zephray/BenqS6-SSD/README.md

# BenqS6-SSD

Replacement SSD for Benq S6

Controller: SM2258XT
Flash: BGA 152pin Flash, up to 2 channel 8 CE
Interface: PATA UDMA up to 150 MB/s (if host supports)
