zephray/BenqS6-SSD/pcb/pcb.kicad_pcb

## KiCad design pcb/pcb.kicad_pcb (2021-12-24)

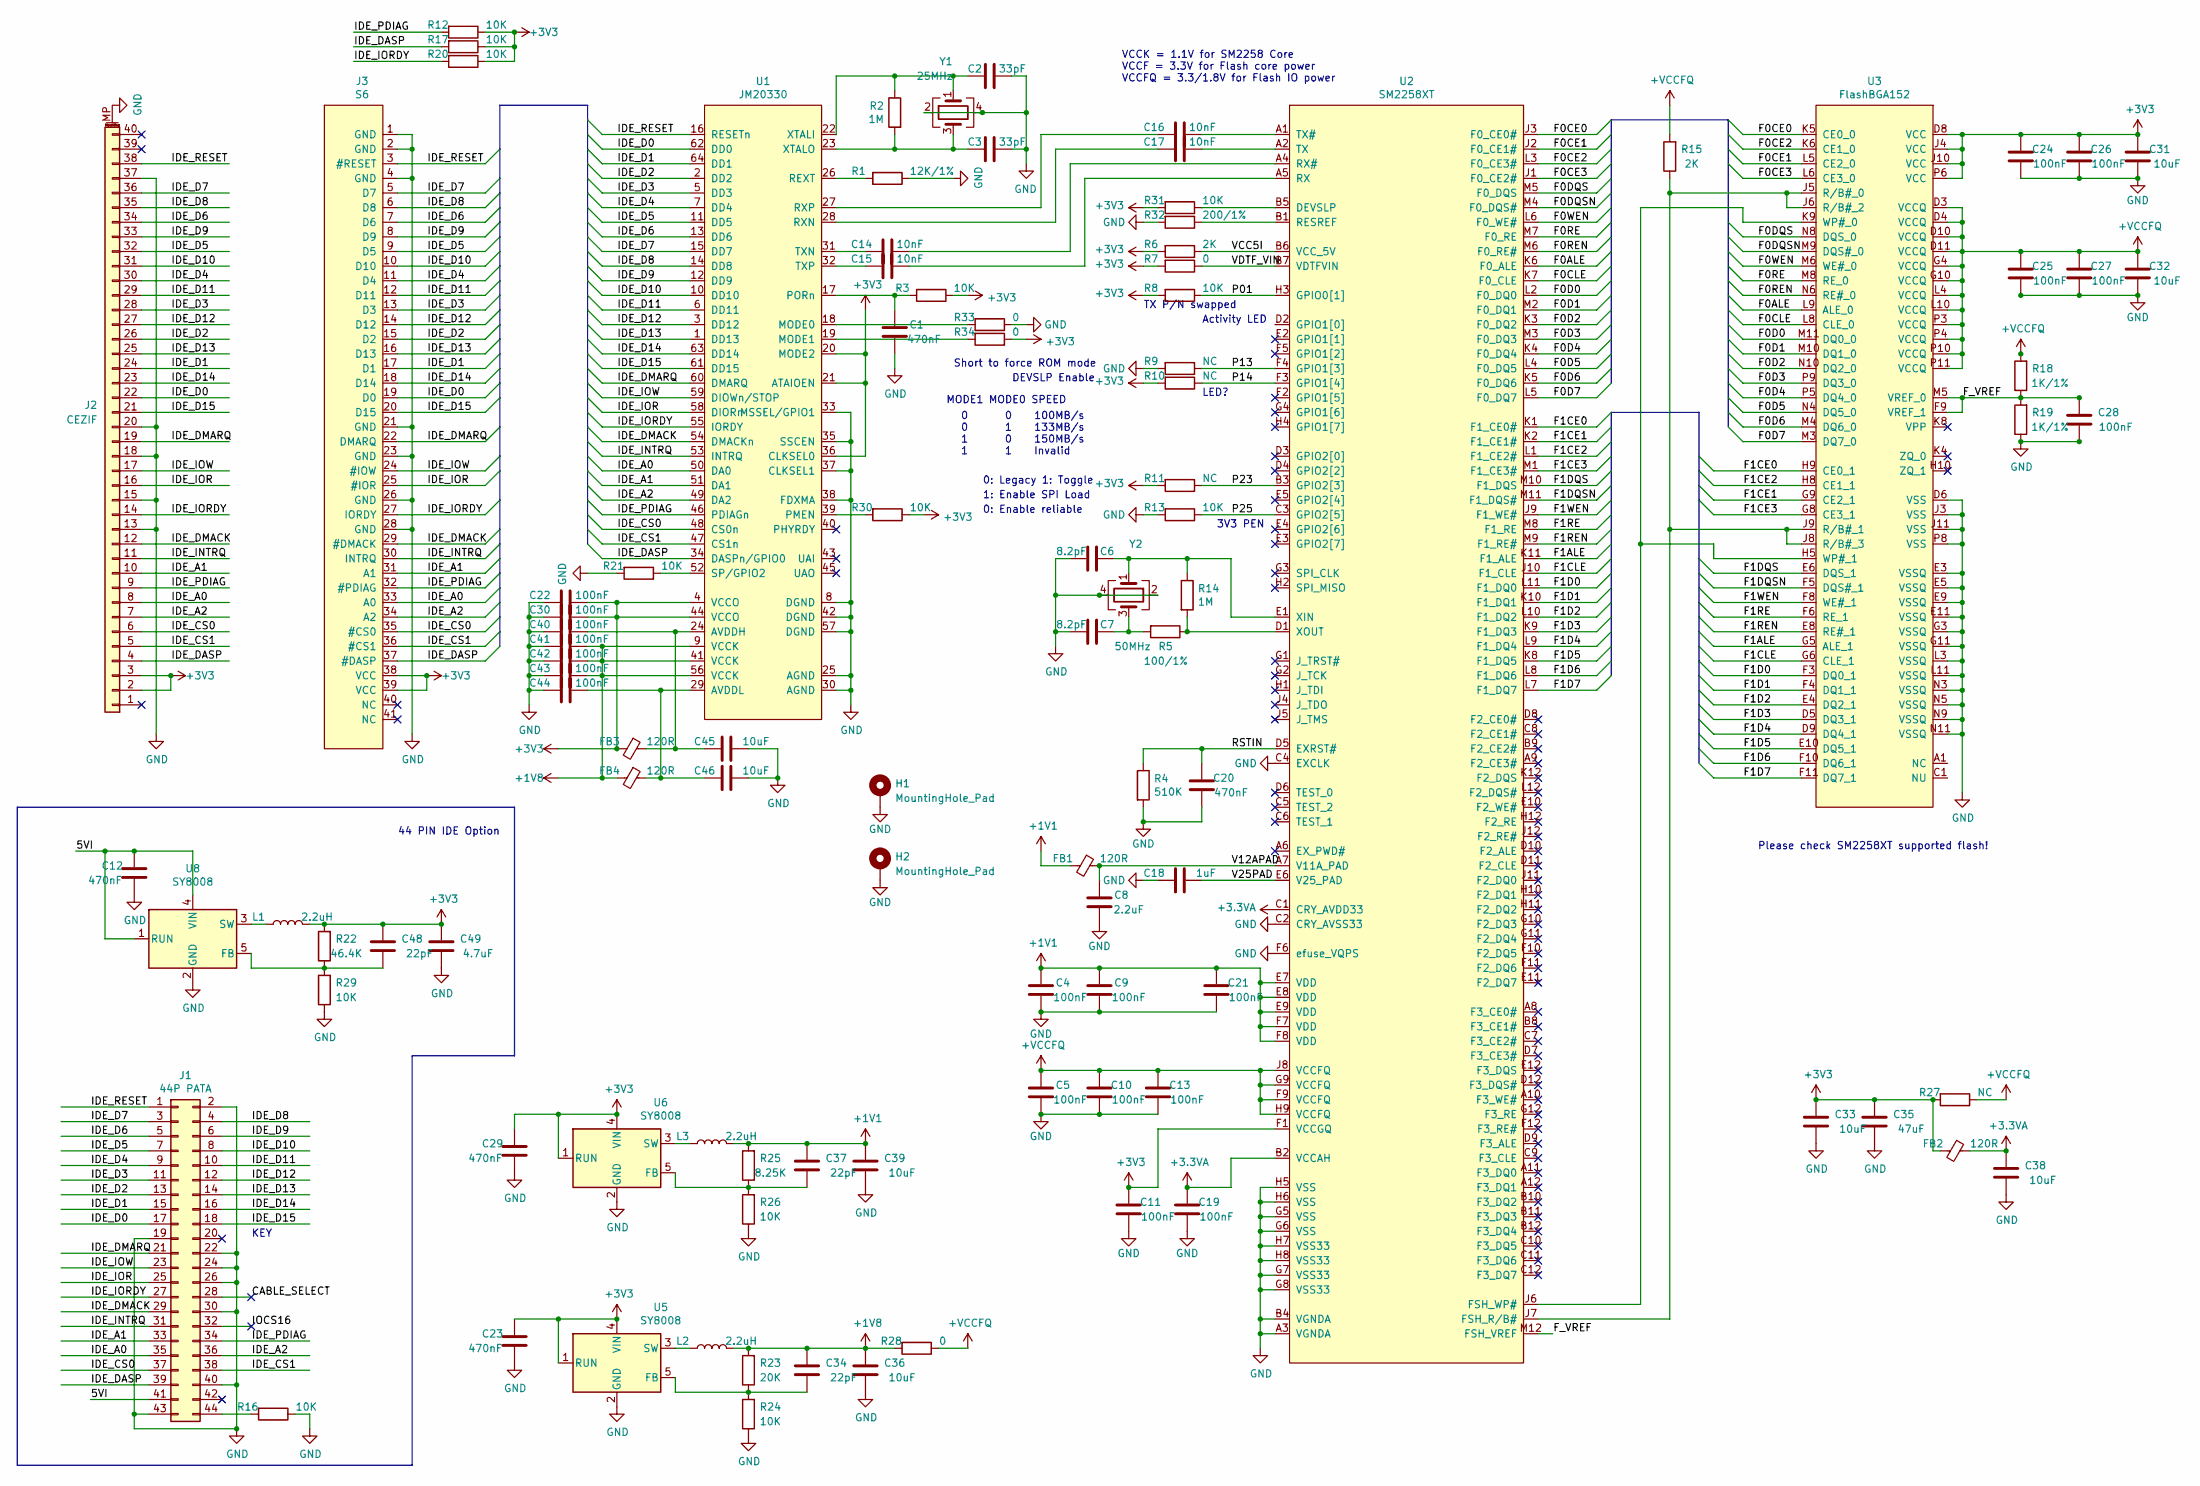
[picture p1: schematic pcb.kicad_sch]

Parts:
C1, C12, C20, C23, C29: 470nF; C_0402_1005Metric
C2, C3: 33pF; C_0402_1005Metric
C4, C5, C9, C10, C11, C13, C19, C21, C22, C24, C25, C26, C27, C28, C30, C40, C41, C42, C43, C44: 100nF; C_0402_1005Metric
C6, C7: 8.2pF; C_0402_1005Metric
C8: 2.2uF; C_0402_1005Metric
C14, C15, C16, C17: 10nF; C_0402_1005Metric
C18: 1uF; C_0402_1005Metric
C31, C32, C33, C36, C38, C39, C45, C46: 10uF; C_0402_1005Metric
C34, C37, C48: 22pF; C_0402_1005Metric
C35: 47uF; C_0805_2012Metric
C49: 4.7uF; C_0402_1005Metric
FB1, FB2, FB3, FB4: 120R; L_0603_1608Metric
H1, H2: MountingHole_Pad; MountingHole_2.2mm_M2_Pad_Via
J1: 44P PATA; PinHeader_2x22_P2.00mm_Vertical
J2: CEZIF; Hirose_FH12-40S-0.5SH_1x40-1MP_P0.50mm_Horizontal
J3: S6; FH35C-41S-0.3SHW
L1, L2, L3: 2.2uH; L_Vishay_IHLP-1212
R1: 12K/1%; R_0402_1005Metric
R2, R14: 1M; R_0402_1005Metric
R3, R8, R12, R13, R16, R17, R20, R21, R24, R26, R29, R30, R31: 10K; R_0402_1005Metric
R4: 510K; R_0402_1005Metric
R5: 100/1%; R_0402_1005Metric
R6, R15: 2K; R_0402_1005Metric
R7, R28, R33, R34: 0; R_0402_1005Metric
R9, R10, R11, R27: NC; R_0402_1005Metric
R18, R19: 1K/1%; R_0402_1005Metric
R22: 46.4K; R_0402_1005Metric
R23: 20K; R_0402_1005Metric
R25: 8.25K; R_0402_1005Metric
R32: 200/1%; R_0402_1005Metric
U1: JM20330; LQFP-64_10x10mm_P0.5mm
U2: SM2258XT; BGA-144_12x12_9.0x9.0mm
U3: FlashBGA152; BGA-152_14x18mm_Layout13x17_P0.5mm
U5, U6, U8: SY8008; TSOT-23-5
Y1: 25MHz; Oscillator_SMD_Abracon_ASE-4Pin_3.2x2.5mm
Y2: 50MHz; Oscillator_SMD_Abracon_ASE-4Pin_3.2x2.5mm

Connections:
+1V1: C4.2, C9.2, C21.2, C37.2, C39.2, FB1.2, L3.2, R25.2, U2.E7 (VDD), U2.E8 (VDD), U2.E9 (VDD), U2.F7 (VDD), U2.F8 (VDD)
+1V8: C34.2, C36.2, C41.2, C42.2, C43.2, FB4.2, L2.2, R23.2, R28.2, U1.9 (VCCK), U1.41 (VCCK), U1.56 (VCCK)
+3.3VA: C19.2, C38.2, FB2.1, U2.B2 (VCCAH), U2.C1 (CRY_AVDD33)
+3V3: C11.2, C22.2, C23.2, C24.2, C26.2, C29.2, C30.2, C31.2, C33.2, C35.2, C48.2, C49.2, FB2.2, FB3.2, J2.2, J2.3, J3.38 (VCC), J3.39 (VCC), L1.2, R3.1, R6.2, R7.2, R8.2, R10.2, R11.2, R12.1, R17.1, R20.1, R22.2, R27.2, R30.1, R31.2, R34.1, U1.4 (VCCO), U1.20 (MODE2), U1.21 (ATAIOEN), U1.36 (CLKSEL0), U1.44 (VCCO), U2.F1 (VCCGQ), U3.D8 (VCC), U3.J4 (VCC), U3.J10 (VCC), U3.P6 (VCC), U5.1 (RUN), U5.4 (VIN), U6.1 (RUN), U6.4 (VIN)
+VCCFQ: C5.2, C10.2, C13.2, C25.2, C27.2, C32.2, R15.2, R18.2, R27.1, R28.1, U2.F9 (VCCFQ), U2.G9 (VCCFQ), U2.H9 (VCCFQ), U2.J8 (VCCFQ), U3.C2 (NU), U3.D3 (VCCQ), U3.D4 (VCCQ), U3.D10 (VCCQ), U3.D11 (VCCQ), U3.G4 (VCCQ), U3.G10 (VCCQ), U3.L4 (VCCQ), U3.L10 (VCCQ), U3.P3 (VCCQ), U3.P4 (VCCQ), U3.P10 (VCCQ), U3.P11 (VCCQ)
/F0ALE: U2.K6 (F0_ALE), U3.L9 (ALE_0)
/F0CE0: U2.J3 (F0_CE0#), U3.K5 (CE0_0)
/F0CE1: U2.J2 (F0_CE1#), U3.L5 (CE2_0)
/F0CE2: U2.L3 (F0_CE3#), U3.K6 (CE1_0)
/F0CE3: U2.J1 (F0_CE2#), U3.L6 (CE3_0)
/F0CLE: U2.K7 (F0_CLE), U3.L8 (CLE_0)
/F0D0: U2.L2 (F0_DQ0), U3.M11 (DQ0_0)
/F0D1: U2.M2 (F0_DQ1), U3.M10 (DQ1_0)
/F0D2: U2.K3 (F0_DQ2), U3.N10 (DQ2_0)
/F0D3: U2.M3 (F0_DQ3), U3.P9 (DQ3_0)
/F0D4: U2.K4 (F0_DQ4), U3.P5 (DQ4_0)
/F0D5: U2.L4 (F0_DQ5), U3.N4 (DQ5_0)
/F0D6: U2.K5 (F0_DQ6), U3.M4 (DQ6_0)
/F0D7: U2.L5 (F0_DQ7), U3.M3 (DQ7_0)
/F0DQS: U2.M5 (F0_DQS), U3.N8 (DQS_0)
/F0DQSN: U2.M4 (F0_DQS#), U3.M9 (DQS#_0)
/F0RE: U2.M7 (F0_RE), U3.M8 (RE_0)
/F0REN: U2.M6 (F0_RE#), U3.N6 (RE#_0)
/F0WEN: U2.L6 (F0_WE#), U3.M6 (WE#_0)
/F1ALE: U2.K11 (F1_ALE), U3.G5 (ALE_1)
/F1CE0: U2.K1 (F1_CE0#), U3.H9 (CE0_1)
/F1CE1: U2.K2 (F1_CE1#), U3.G9 (CE2_1)
/F1CE2: U2.L1 (F1_CE2#), U3.H8 (CE1_1)
/F1CE3: U2.M1 (F1_CE3#), U3.G8 (CE3_1)
/F1CLE: U2.J10 (F1_CLE), U3.G6 (CLE_1)
/F1D0: U2.L11 (F1_DQ0), U3.F3 (DQ0_1)
/F1D1: U2.K10 (F1_DQ1), U3.F4 (DQ1_1)
/F1D2: U2.L10 (F1_DQ2), U3.E4 (DQ2_1)
/F1D3: U2.K9 (F1_DQ3), U3.D5 (DQ3_1)
/F1D4: U2.L9 (F1_DQ4), U3.D9 (DQ4_1)
/F1D5: U2.K8 (F1_DQ5), U3.E10 (DQ5_1)
/F1D6: U2.L8 (F1_DQ6), U3.F10 (DQ6_1)
/F1D7: U2.L7 (F1_DQ7), U3.F11 (DQ7_1)
/F1DQS: U2.M10 (F1_DQS), U3.E6 (DQS_1)
/F1DQSN: U2.M11 (F1_DQS#), U3.F5 (DQS#_1)
/F1RE: U2.M8 (F1_RE), U3.F6 (RE_1)
/F1REN: U2.M9 (F1_RE#), U3.E8 (RE#_1)
/F1WEN: U2.J9 (F1_WE#), U3.F8 (WE#_1)
/F_VREF: C28.2, R18.1, R19.2, U2.M12 (FSH_VREF), U3.B1 (NC), U3.D1 (NU), U3.F9 (VREF_1), U3.M5 (VREF_0)
/IDE_A0: J1.35, J2.8, J3.33 (A0), U1.50 (DA0)
/IDE_A1: J1.33, J2.10, J3.31 (A1), U1.51 (DA1)
/IDE_A2: J1.36, J2.7, J3.34 (A2), U1.49 (DA2)
/IDE_CS0: J1.37, J2.6, J3.35 (#CS0), U1.48 (CS0n)
/IDE_CS1: J1.38, J2.5, J3.36 (#CS1), U1.47 (CS1n)
/IDE_D0: J1.17, J2.22, J3.19 (D0), U1.62 (DD0)
/IDE_D1: J1.15, J2.24, J3.17 (D1), U1.64 (DD1)
/IDE_D2: J1.13, J2.26, J3.15 (D2), U1.2 (DD2)
/IDE_D3: J1.11, J2.28, J3.13 (D3), U1.5 (DD3)
/IDE_D4: J1.9, J2.30, J3.11 (D4), U1.7 (DD4)
/IDE_D5: J1.7, J2.32, J3.9 (D5), U1.11 (DD5)
/IDE_D6: J1.5, J2.34, J3.7 (D6), U1.13 (DD6)
/IDE_D7: J1.3, J2.36, J3.5 (D7), U1.15 (DD7)
/IDE_D8: J1.4, J2.35, J3.6 (D8), U1.14 (DD8)
/IDE_D9: J1.6, J2.33, J3.8 (D9), U1.12 (DD9)
/IDE_D10: J1.8, J2.31, J3.10 (D10), U1.10 (DD10)
/IDE_D11: J1.10, J2.29, J3.12 (D11), U1.6 (DD11)
/IDE_D12: J1.12, J2.27, J3.14 (D12), U1.3 (DD12)
/IDE_D13: J1.14, J2.25, J3.16 (D13), U1.1 (DD13)
/IDE_D14: J1.16, J2.23, J3.18 (D14), U1.63 (DD14)
/IDE_D15: J1.18, J2.21, J3.20 (D15), U1.61 (DD15)
/IDE_DASP: J1.39, J2.4, J3.37 (#DASP), R17.2, U1.34 (DASPn/GPIO0)
/IDE_DMACK: J1.29, J2.12, J3.29 (#DMACK), U1.54 (DMACKn)
/IDE_DMARQ: J1.21, J2.19, J3.22 (DMARQ), U1.60 (DMARQ)
/IDE_INTRQ: J1.31, J2.11, J3.30 (INTRQ), U1.53 (INTRQ)
/IDE_IOR: J1.25, J2.16, J3.25 (#IOR), U1.58 (DIORn)
/IDE_IORDY: J1.27, J2.14, J3.27 (IORDY), R20.2, U1.55 (IORDY)
/IDE_IOW: J1.23, J2.17, J3.24 (#IOW), U1.59 (DIOWn/STOP)
/IDE_PDIAG: J1.34, J2.9, J3.32 (#PDIAG), R12.2, U1.46 (PDIAGn)
/IDE_RESET: J1.1, J2.38, J3.3 (#RESET), U1.16 (RESETn)
/P01: R8.1, U2.H3 (GPIO0[1])
/P13: R9.1, U2.F4 (GPIO1[3])
/P14: R10.1, U2.F3 (GPIO1[4])
/P23: R11.1, U2.B3 (GPIO2[3])
/P25: R13.1, U2.C3 (GPIO2[5])
/RSTIN: C20.2, R4.1, U2.D5 (EXRST#)
/V12APAD: C8.2, FB1.1, U2.A7 (V11A_PAD)
/V25PAD: C18.2, U2.E6 (V25_PAD)
/VCC5I: R6.1, U2.B6 (VCC_5V)
/VDTF_VIN: R7.1, U2.B7 (VDTFVIN)
GND: C1.1, C2.2, C3.2, C4.1, C5.1, C6.2, C7.2, C8.1, C9.1, C10.1, C11.1, C12.1, C13.1, C18.1, C19.1, C20.1, C21.1, C22.1, C23.1, C24.1, C25.1, C26.1, C27.1, C28.1, C29.1, C30.1, C31.1, C32.1, C33.1, C35.1, C36.1, C38.1, C39.1, C40.1, C41.1, C42.1, C43.1, C44.1, C45.1, C46.1, C49.1, H1.1, H2.1, J1.2, J1.19, J1.22, J1.24, J1.26, J1.30, J1.40, J1.43, J2.13, J2.15, J2.18, J2.20, J2.37, J2.MP (MountPin), J3.1 (GND), J3.2 (GND), J3.4 (GND), J3.21 (GND), J3.23 (GND), J3.26 (GND), J3.28 (GND), R1.1, R4.2, R9.2, R13.2, R16.1, R19.1, R21.2, R24.1, R26.1, R29.1, R32.2, R33.1, U1.8 (DGND), U1.25 (AGND), U1.30 (AGND), U1.33 (MSSEL/GPIO1), U1.35 (SSCEN), U1.37 (CLKSEL1), U1.38 (FDXMA), U1.42 (DGND), U1.57 (DGND), U2.A3 (VGNDA), U2.B4 (VGNDA), U2.C2 (CRY_AVSS33), U2.C4 (EXCLK), U2.F6 (efuse_VQPS), U2.G5 (VSS), U2.G6 (VSS), U2.G7 (VSS33), U2.G8 (VSS33), U2.H5 (VSS), U2.H6 (VSS), U2.H7 (VSS33), U2.H8 (VSS33), U3.A10 (NC), U3.B12 (NC), U3.C10 (NU), U3.D2 (NU), U3.D6 (VSS), U3.E3 (VSSQ), U3.E5 (VSSQ), U3.E9 (VSSQ), U3.E11 (VSSQ), U3.G3 (VSSQ), U3.G11 (VSSQ), U3.J3 (VSS), U3.J11 (VSS), U3.L3 (VSSQ), U3.L11 (VSSQ), U3.N3 (VSSQ), U3.N5 (VSSQ), U3.N9 (VSSQ), U3.N11 (VSSQ), U3.P8 (VSS), U5.2 (GND), U6.2 (GND), U8.2 (GND), Y1.2, Y1.4, Y2.2, Y2.4
unnamed: C1.2, R3.2, U1.17 (PORn)
unnamed: C2.1, R2.1, U1.22 (XTALI), Y1.1
unnamed: C3.1, R2.2, U1.23 (XTALO), Y1.3
unnamed: C6.1, R14.1, U2.E1 (XIN), Y2.1
unnamed: C7.1, R5.2, Y2.3
unnamed: C12.2, J1.41, U8.1 (RUN), U8.4 (VIN)
unnamed: C14.1, U1.31 (TXN)
unnamed: C14.2, U2.A4 (RX#)
unnamed: C15.1, U1.32 (TXP)
unnamed: C15.2, U2.A5 (RX)
unnamed: C16.1, U1.27 (RXP)
unnamed: C16.2, U2.A1 (TX#)
unnamed: C17.1, U1.28 (RXN)
unnamed: C17.2, U2.A2 (TX)
unnamed: C34.1, R23.1, R24.2, U5.5 (FB)
unnamed: C37.1, R25.1, R26.2, U6.5 (FB)
unnamed: C40.2, C45.2, FB3.1, U1.24 (AVDDH)
unnamed: C44.2, C46.2, FB4.1, U1.29 (AVDDL)
unnamed: C48.1, R22.1, R29.2, U8.5 (FB)
unnamed: J1.44, R16.2
unnamed: L1.1, U8.3 (SW)
unnamed: L2.1, U5.3 (SW)
unnamed: L3.1, U6.3 (SW)
unnamed: R1.2, U1.26 (REXT)
unnamed: R5.1, R14.2, U2.D1 (XOUT)
unnamed: R15.1, U2.J7 (FSH_R/B#), U3.J5 (R/B#_0), U3.J6 (R/B#_2), U3.J8 (R/B#_3), U3.J9 (R/B#_1)
unnamed: R21.1, U1.52 (SP/GPIO2)
unnamed: R30.2, U1.39 (PMEN)
unnamed: R31.1, U2.B5 (DEVSLP)
unnamed: R32.1, U2.B1 (RESREF)
unnamed: R33.2, U1.18 (MODE0)
unnamed: R34.2, U1.19 (MODE1)
unnamed: U2.J6 (FSH_WP#), U3.H5 (WP#_1), U3.K9 (WP#_0)

Notes on the sheet:
0 0 1 1
Please check SM2258XT supported flash!
1: Enable SPI Load
3V3 PEN
TX P/N swapped
LED?
0 1 0 1
Activity LED
MODE1 MODE0 SPEED
Short to force ROM mode
0: Enable reliable
100MB/s 133MB/s 150MB/s Invalid
KEY
VCCK = 1.1V for SM2258 Core VCCF = 3.3V for Flash core power VCCFQ = 3.3/1.8V for Flash IO power
44 PIN IDE Option
DEVSLP Enable
0: Legacy 1: Toggle

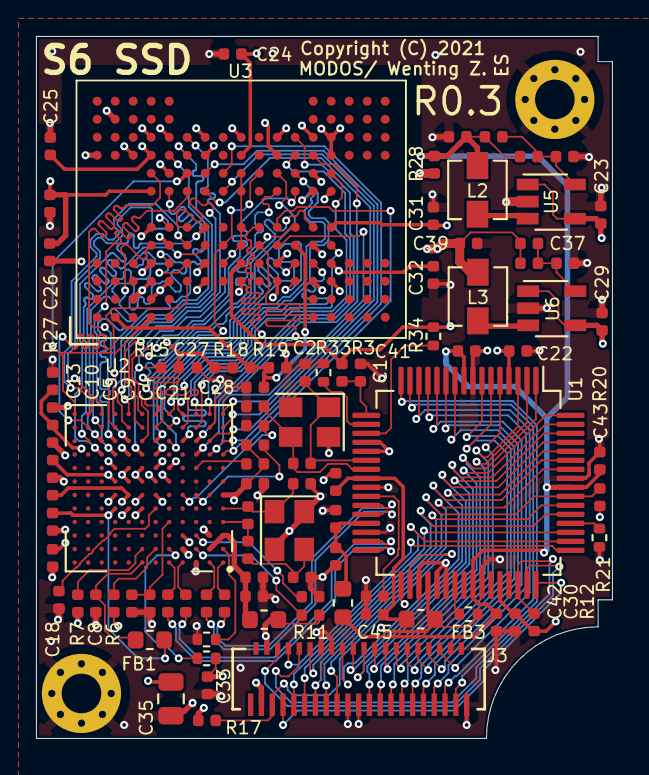
[picture p2: board pcb.kicad_pcb from above]

Board: 4 copper layers, 32.0 x 39.0 mm, 92 parts (0 on the bottom side), 114 nets.
