zephray/BenqS6-SSD/(commit log)

2020-10-25 Schematics first revision
    [pcb.kicad_pcb, pcb.sch]
2020-10-31 Working on layout
    [pcb.kicad_pcb]
2020-11-04 First revision freeze
    [pcb.kicad_pcb, pcb.sch]
2021-11-19 Upgrade to 5.99, clean up
    [pcb.kicad_pcb, pcb.kicad_sch, pcb.sch]
2021-11-28 Upgrade to new nightly, remove 5V charge pump, add UDMA speed option resistor
    [pcb.kicad_sch]
2021-12-24 Rev 0.3
    [pcb.kicad_pcb, pcb.kicad_sch]
