zephray/BenqS6-SSD/(notices)

Notices in the files:
pcb/pcb.kicad_pcb:
Copyright Wenting Zhang 2021
This device is Open Hardware and the
design source is licensed under the
CERN-OHL-P v2. You could download
Copyright (C) 2021
